OLIMEX/UEXT-LVL-SHIFT/HARDWARE/UEXT-LVL-SHIFT_Rev_A/UEXT-LVL-SHIFT_Rev_A_BOM.csv

Quantity | Value | Footprint | Reference
1 | 47uF/6.3V/20%/X5R/C0805 | C_0805_5MIL_DWS | C1
6 | 1uF/6.3V/10%/X5R/C0402 | C_0402_5MIL_DWS | C2, C3, C4, C5, C6, C7
4 | BSS138(SOT23-3) | SOT23 | FET1, FET2, FET3, FET4
6 | 10k/R0402 | R_0402_5MIL_DWS | R1, R2, R6, R7, R11, R12
4 | 1k/R0402 | R_0402_5MIL_DWS | R3, R4, R9, R10
2 | 2.2k/R0402 | R_0402_5MIL_DWS | R5, R8
3 | SN74LVC2T45DCUR(VSSOP-8) | VSSOP-8_Pitch-0.50mm_Pad-0.25mm_Dimensions-2.30x2.00x1.00mm | U1, U2, U3
2 | P-B-V-10-LF | GBH-254-SMT-10 | UEXT_1.65V_to_5V5, UEXT_3V3
