OLIMEX/UEXT-LVL-SHIFT/HARDWARE/UEXT-LVL-SHIFT_Rev_A/UEXT-LVL-SHIFT_Rev_A.pdf

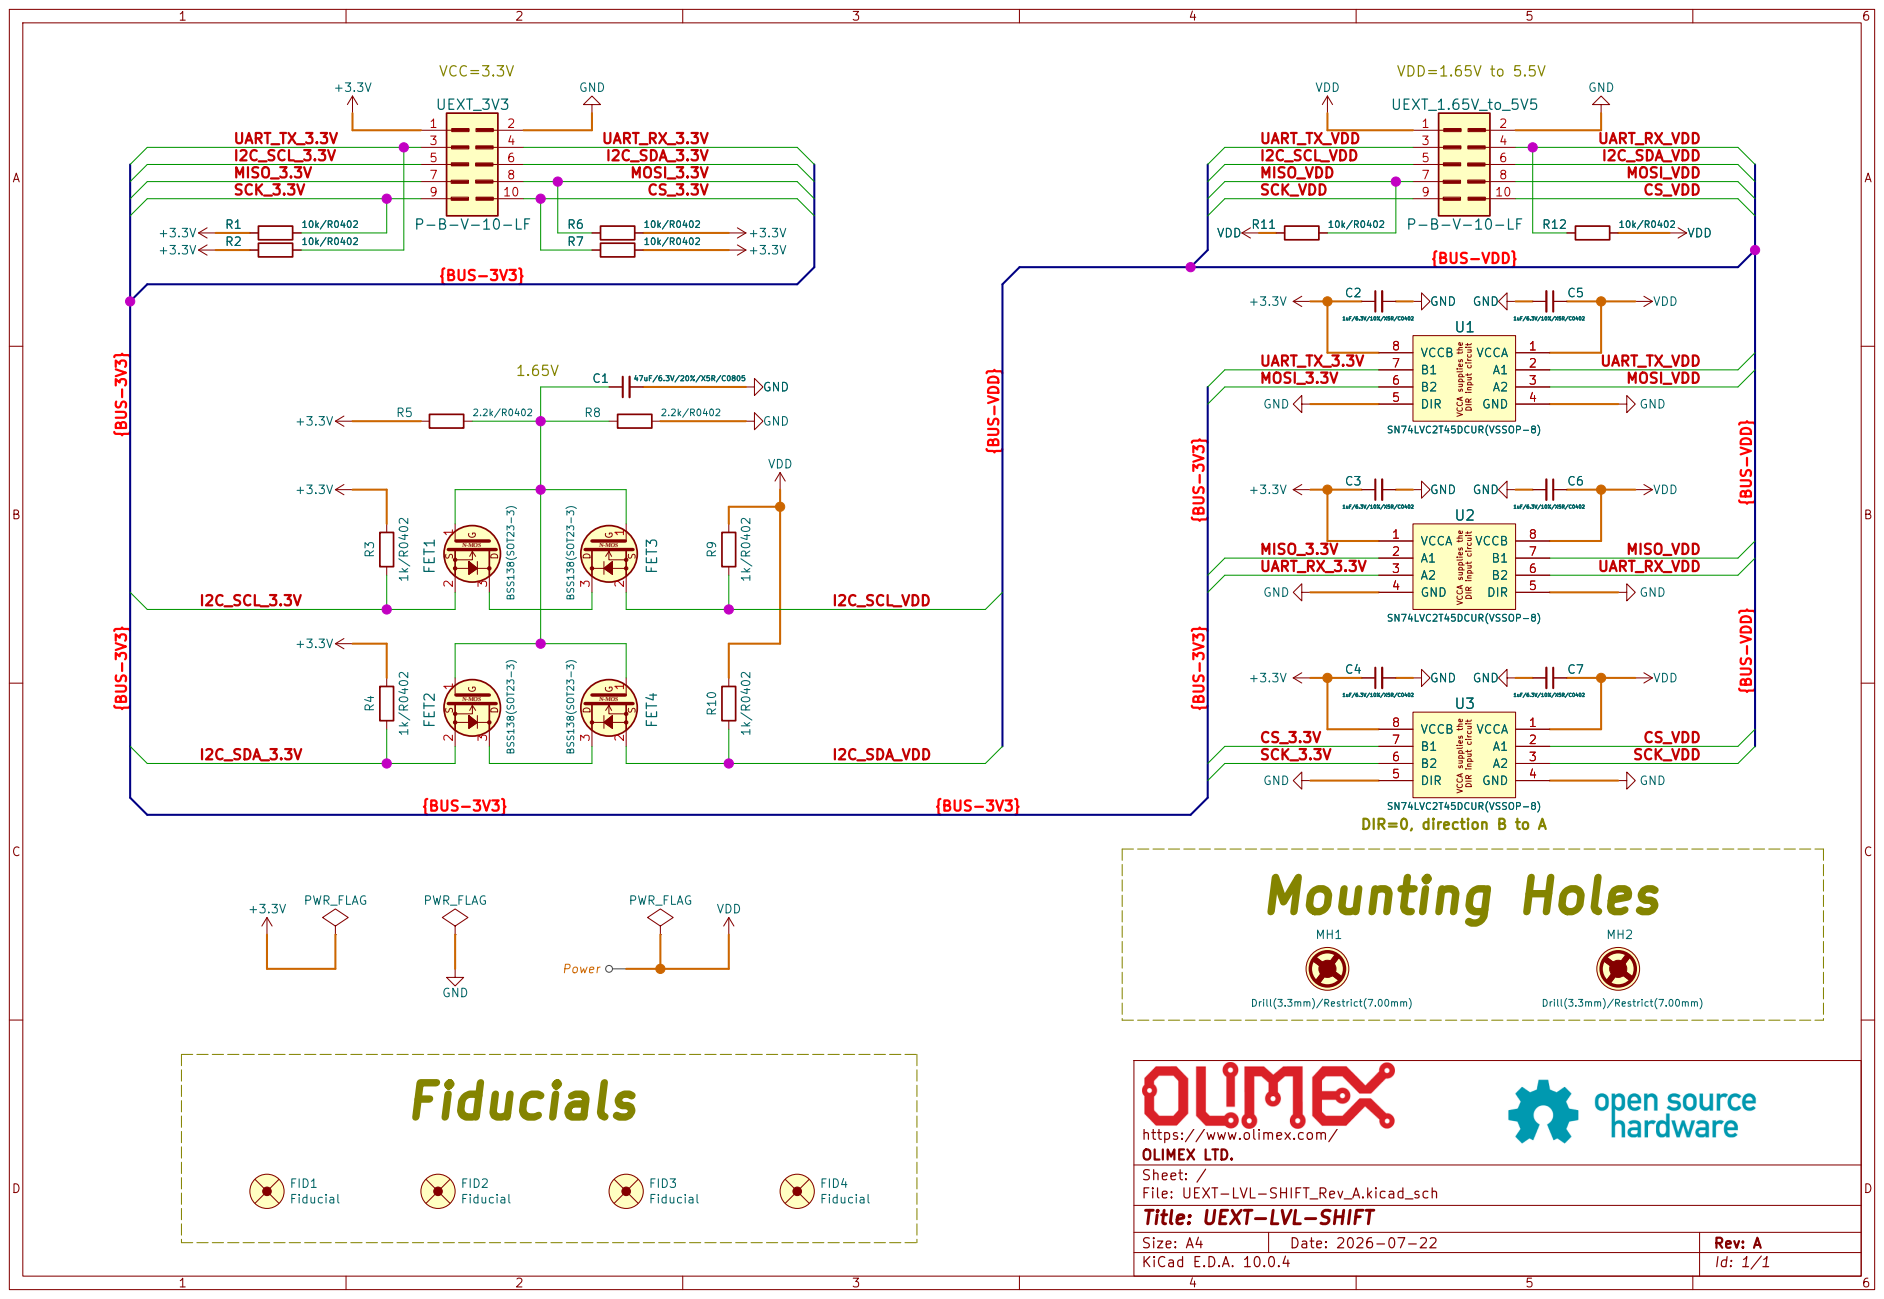
[picture p2: page 1]

OLIMEX LTD.
Sheet: /
File: UEXT-LVL-SHIFT_Rev_A.kicad_sch
Title: UEXT-LVL-SHIFT

Size: A4 | Rev: A
KiCad E.D.A. 10.0.4 | Id: 1/1
