OLIMEX/UEXT-LVL-SHIFT/HARDWARE/UEXT-LVL-SHIFT_Rev_A/UEXT-LVL-SHIFT_Rev_A.kicad_pcb

## KiCad design HARDWARE/UEXT-LVL-SHIFT_Rev_A/UEXT-LVL-SHIFT_Rev_A.kicad_pcb (2026-10-19)

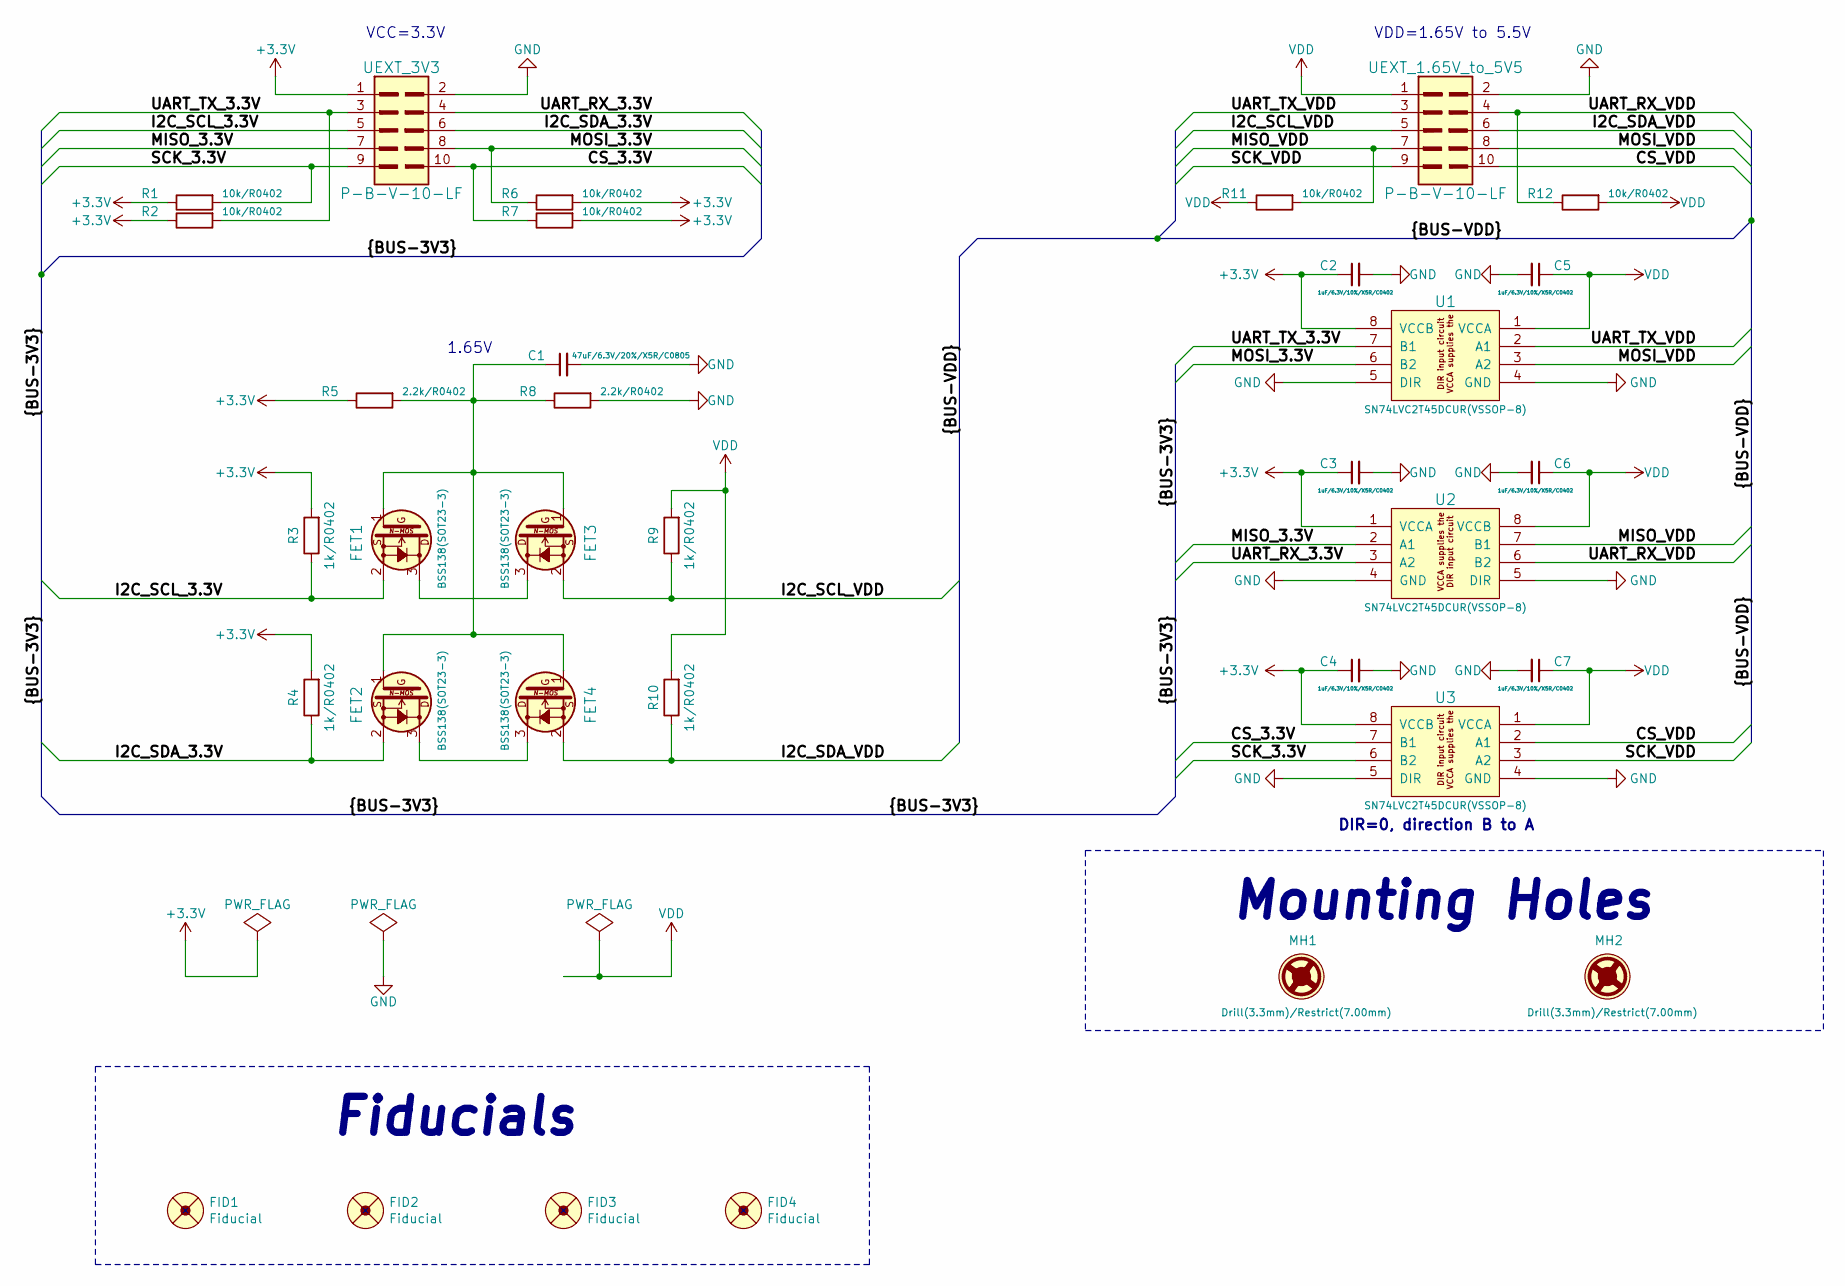
[picture p3: schematic UEXT-LVL-SHIFT_Rev_A.kicad_sch, UEXT-LVL-SHIFT]

Parts:
C1: 47uF/6.3V/20%/X5R/C0805; C_0805_5MIL_DWS
C2, C3, C4, C5, C6, C7: 1uF/6.3V/10%/X5R/C0402; C_0402_5MIL_DWS
FET1, FET2, FET3, FET4: BSS138(SOT23-3); SOT23
FID1, FID3: Fiducial; Fiducial1x3
FID2, FID4: Fiducial; Fiducial1x3_Paste
MH1, MH2: Drill(3.3mm)/Restrict(7.00mm); Mounting_Hole_Drill-3.3mm_Clerance-7mm
R1, R2, R6, R7, R11, R12: 10k/R0402; R_0402_5MIL_DWS
R3, R4, R9, R10: 1k/R0402; R_0402_5MIL_DWS
R5, R8: 2.2k/R0402; R_0402_5MIL_DWS
U1, U2, U3: SN74LVC2T45DCUR(VSSOP-8); VSSOP-8_Pitch-0.50mm_Pad-0.25mm_Dimensions-2.30x2.00x1.00mm
UEXT_1.65V_to_5V5, UEXT_3V3: P-B-V-10-LF; GBH-254-SMT-10

Connections:
+3.3V: C2.1, C3.1, C4.1, R1.1, R2.1, R3.2, R4.2, R5.1, R6.2, R7.2, U1.8 (VCCB), U2.1 (VCCA), U3.8 (VCCB), UEXT_3V3.1
/CS_3.3V: R7.1, U3.7 (B1), UEXT_3V3.10
/CS_VDD: U3.2 (A1), UEXT_1.65V_to_5V5.10
/I2C_SCL_3.3V: FET1.2 (S), R3.1, UEXT_3V3.5
/I2C_SCL_VDD: FET3.2 (S), R9.1, UEXT_1.65V_to_5V5.5
/I2C_SDA_3.3V: FET2.2 (S), R4.1, UEXT_3V3.6
/I2C_SDA_VDD: FET4.2 (S), R10.1, UEXT_1.65V_to_5V5.6
/MISO_3.3V: U2.2 (A1), UEXT_3V3.7
/MISO_VDD: R11.2, U2.7 (B1), UEXT_1.65V_to_5V5.7
/MOSI_3.3V: R6.1, U1.6 (B2), UEXT_3V3.8
/MOSI_VDD: U1.3 (A2), UEXT_1.65V_to_5V5.8
/SCK_3.3V: R1.2, U3.6 (B2), UEXT_3V3.9
/SCK_VDD: U3.3 (A2), UEXT_1.65V_to_5V5.9
/UART_RX_3.3V: U2.3 (A2), UEXT_3V3.4
/UART_RX_VDD: R12.1, U2.6 (B2), UEXT_1.65V_to_5V5.4
/UART_TX_3.3V: R2.2, U1.7 (B1), UEXT_3V3.3
/UART_TX_VDD: U1.2 (A1), UEXT_1.65V_to_5V5.3
GND: C1.2, C2.2, C3.2, C4.2, C5.2, C6.2, C7.2, R8.2, U1.4 (GND), U1.5 (DIR), U2.4 (GND), U2.5 (DIR), U3.4 (GND), U3.5 (DIR), UEXT_1.65V_to_5V5.2, UEXT_3V3.2
unnamed: FET1.3 (D), FET3.3 (D)
unnamed: C1.1, FET1.1 (G), FET2.1 (G), FET3.1 (G), FET4.1 (G), R5.2, R8.1
unnamed: FET2.3 (D), FET4.3 (D)
VDD: C5.1, C6.1, C7.1, R9.2, R10.2, R11.1, R12.2, U1.1 (VCCA), U2.8 (VCCB), U3.1 (VCCA), UEXT_1.65V_to_5V5.1

Notes on the sheet:
VDD=1.65V to 5.5V
DIR=0, direction B to A
Mounting Holes
1.65V
Fiducials
VCC=3.3V

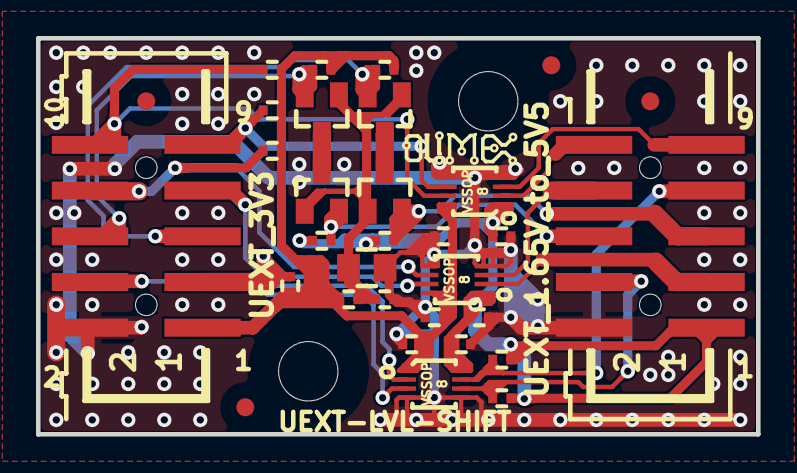
[picture p4: board UEXT-LVL-SHIFT_Rev_A.kicad_pcb from above]

Board: 2 copper layers, 40.0 x 22.0 mm, 42 parts (7 on the bottom side), 22 nets.

Other parts of the board:
Logo_OLIMEX_SMALL_TB: Logo_OLIMEX_SMALL_TB
Logo_OLIMEX_TB-Top: Logo_OLIMEX_TB
Sign_Antistatic: Sign_Antistatic
Sign_CE: CE_Sign
Sign_OSHW_8x8: Sign_OSHW_8x8
Sign_PB-Free: Sign_PB-Free
Sign_RecycleBin: Sign_RecycleBin; Sign_RecycleBin_1
Sign_RoHS: Sign_RoHS; Sign_RoHS_1
