OLIMEX/UEXT-LVL-SHIFT/(notices)

Notices in the files:
HARDWARE/UEXT-LVL-SHIFT_Rev_A/UEXT-LVL-SHIFT_Rev_A.kicad_pcb:
(C) 2026
